Zakkysyy/poltekom-ess-enclosure/06_dokumentasi_visual/arsitektur_stack_tunnel_dan_case.png

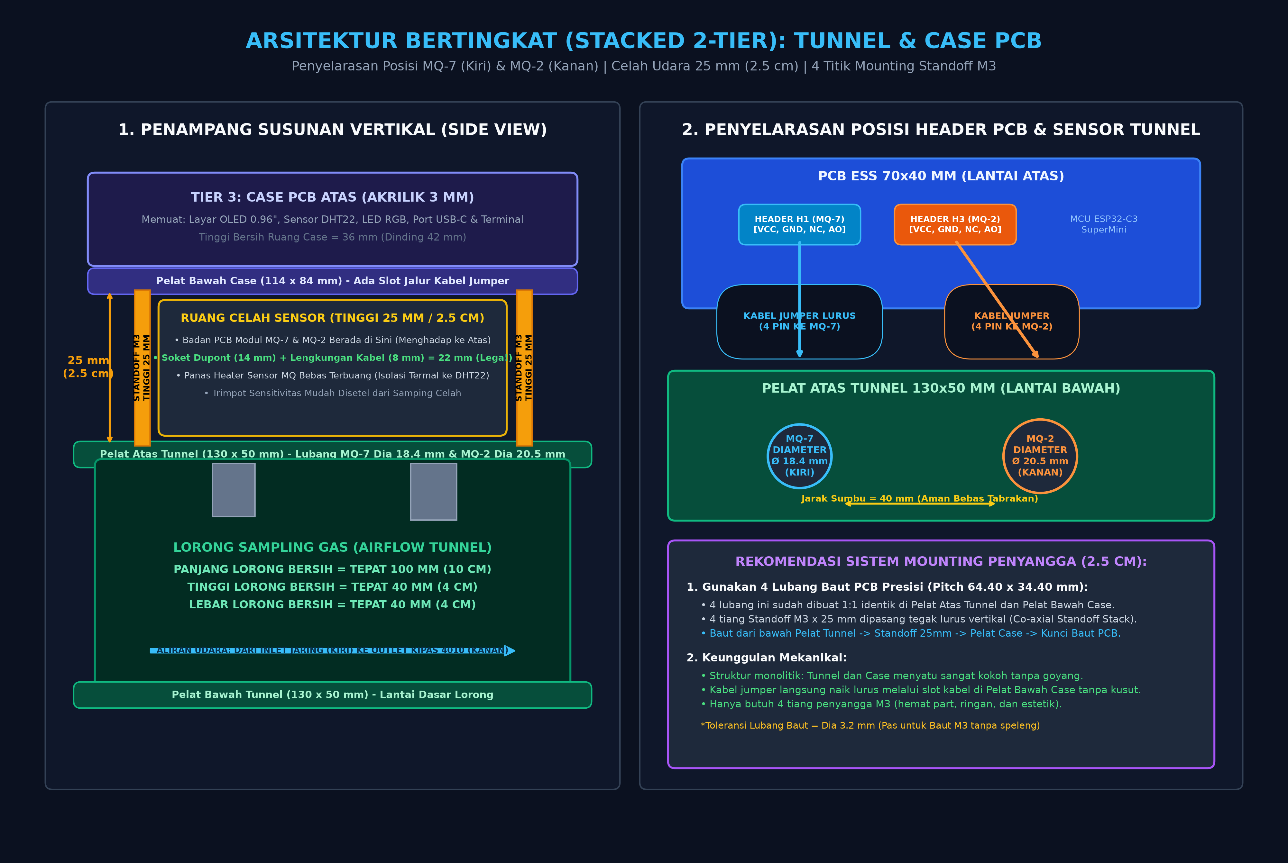
06_dokumentasi_visual/arsitektur_stack_tunnel_dan_case.png
