Zakkysyy/poltekom-ess-enclosure/06_dokumentasi_visual/desain_2d_3d_modul_mq2_mq7_pcb.png

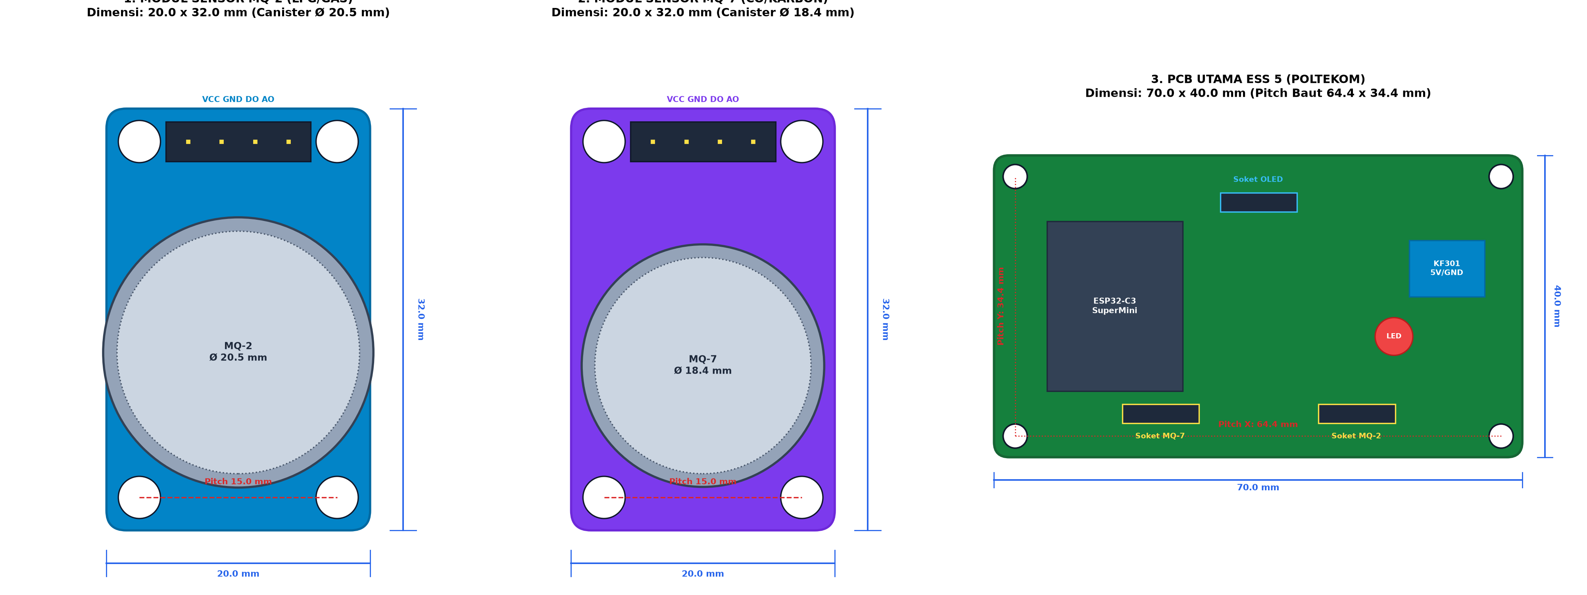
06_dokumentasi_visual/desain_2d_3d_modul_mq2_mq7_pcb.png
