Zakkysyy/poltekom-ess-enclosure/06_dokumentasi_visual/desain_3d_spacer_male_female_m3_50mm.png

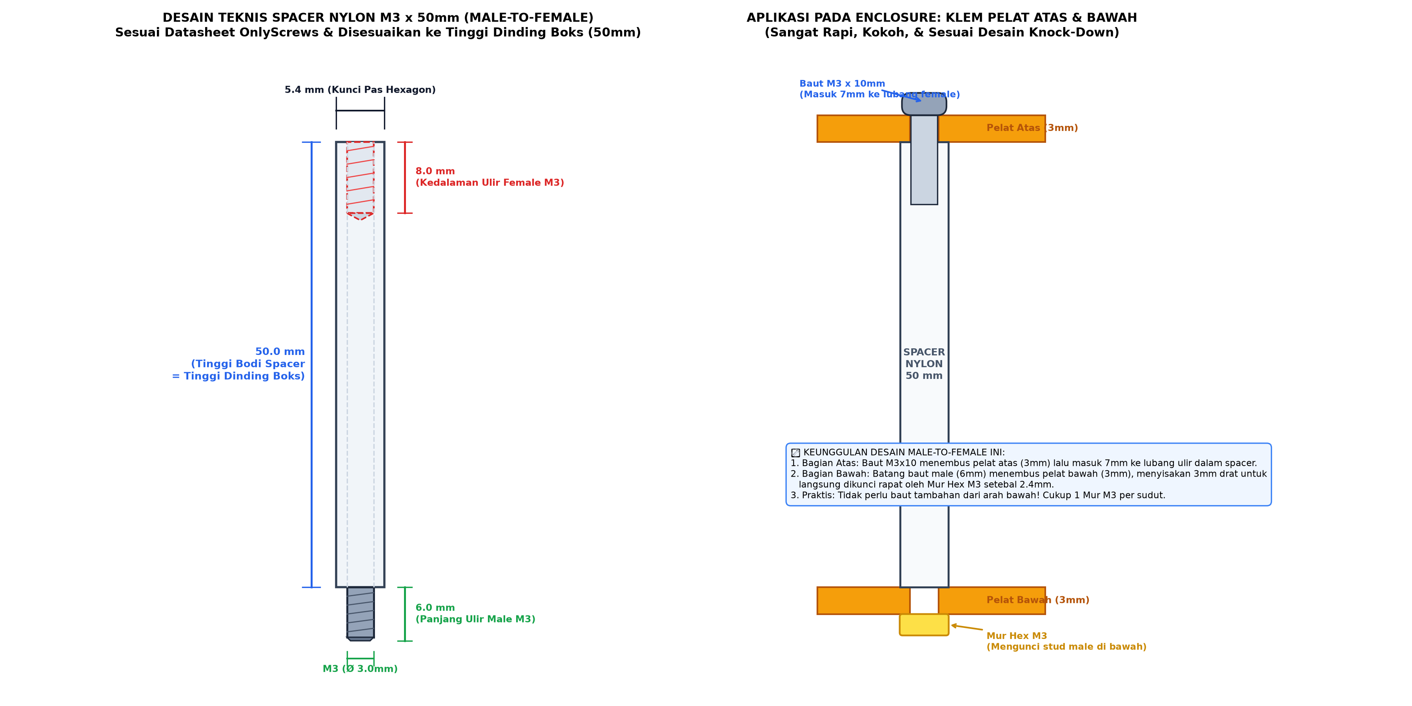
06_dokumentasi_visual/desain_3d_spacer_male_female_m3_50mm.png
