Zakkysyy/poltekom-ess-enclosure/06_dokumentasi_visual/panduan_baut_5mm_datasheet_onshape.png

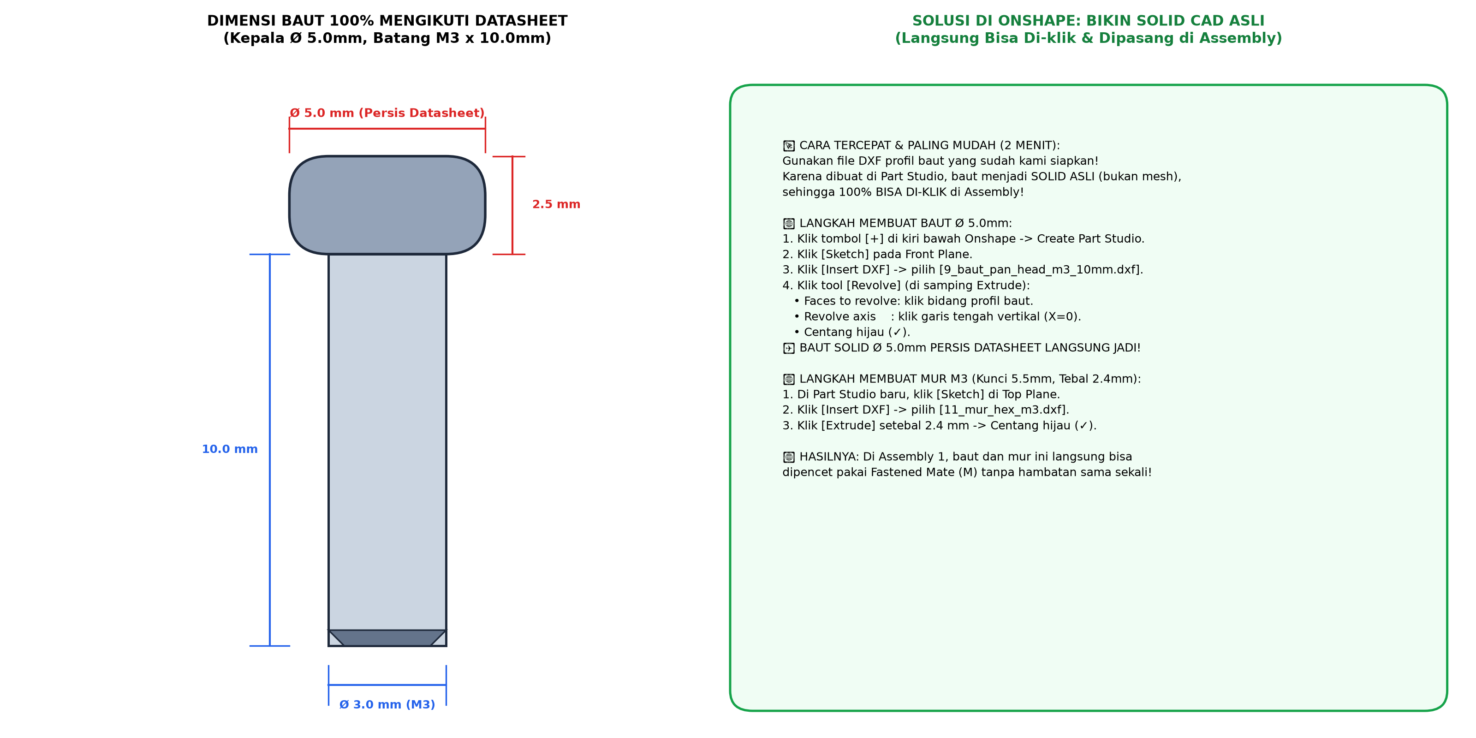
06_dokumentasi_visual/panduan_baut_5mm_datasheet_onshape.png
