Zakkysyy/poltekom-ess-enclosure/06_dokumentasi_visual/panduan_bikin_ulir_onshape.png

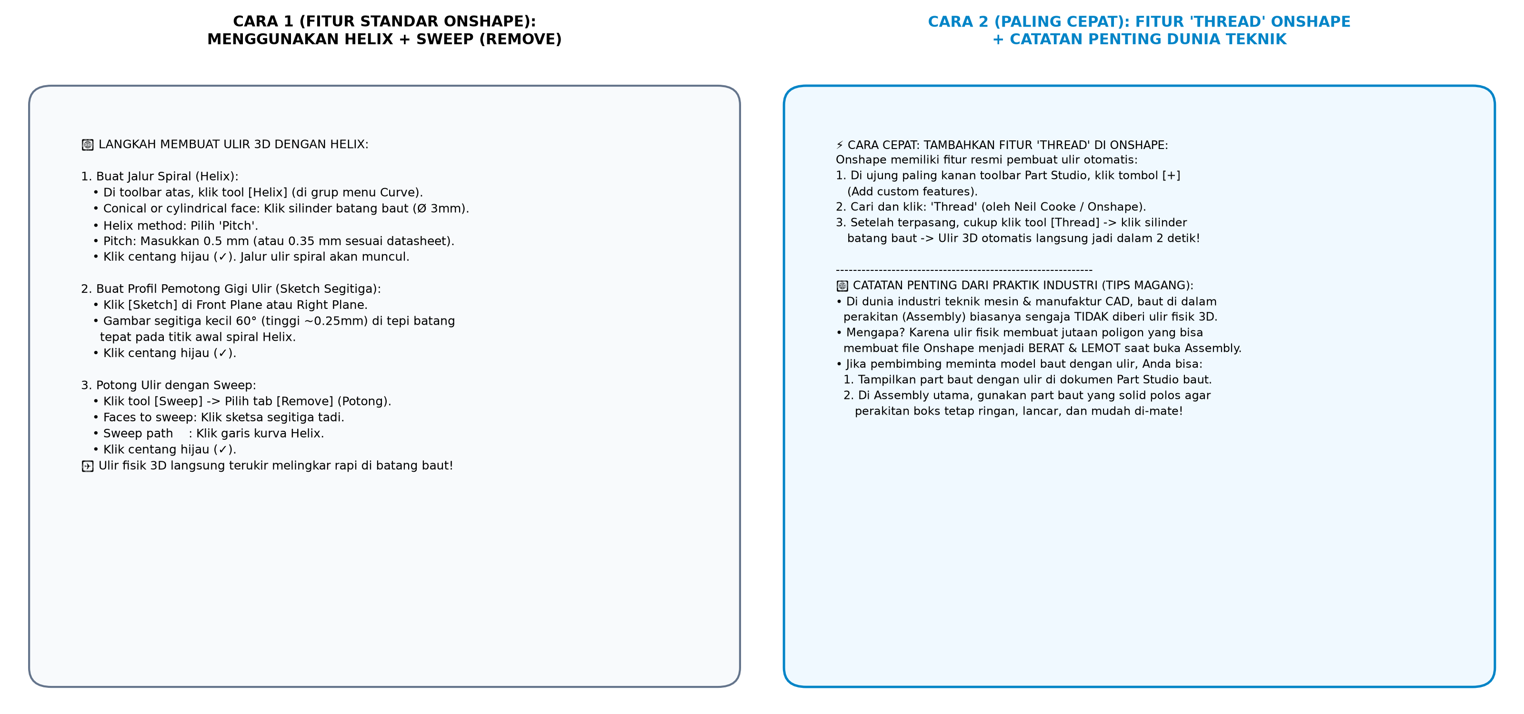
06_dokumentasi_visual/panduan_bikin_ulir_onshape.png
