Zakkysyy/poltekom-ess-enclosure/06_dokumentasi_visual/panduan_mate_baut_dan_mur_onshape.png

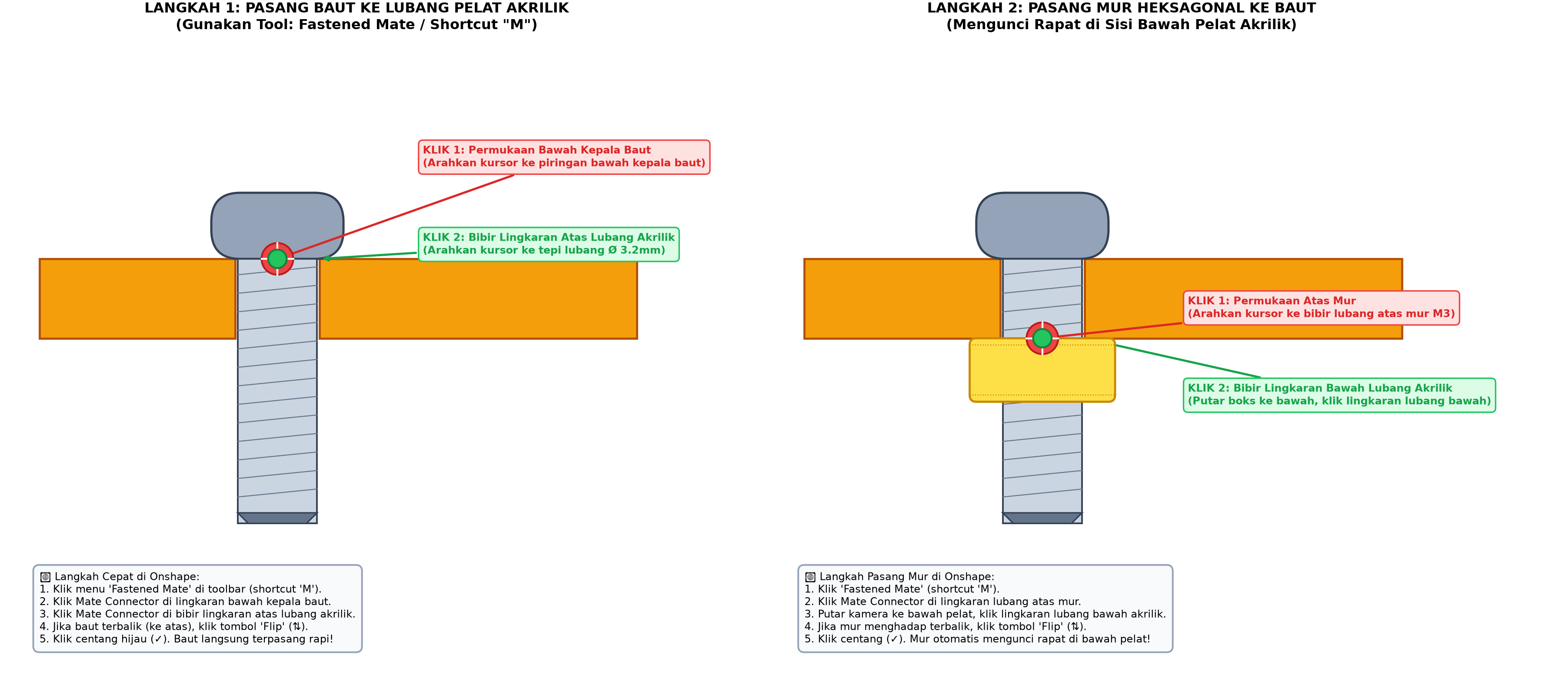
06_dokumentasi_visual/panduan_mate_baut_dan_mur_onshape.png
