Zakkysyy/poltekom-ess-enclosure/06_dokumentasi_visual/preview_a4_halaman_1.png

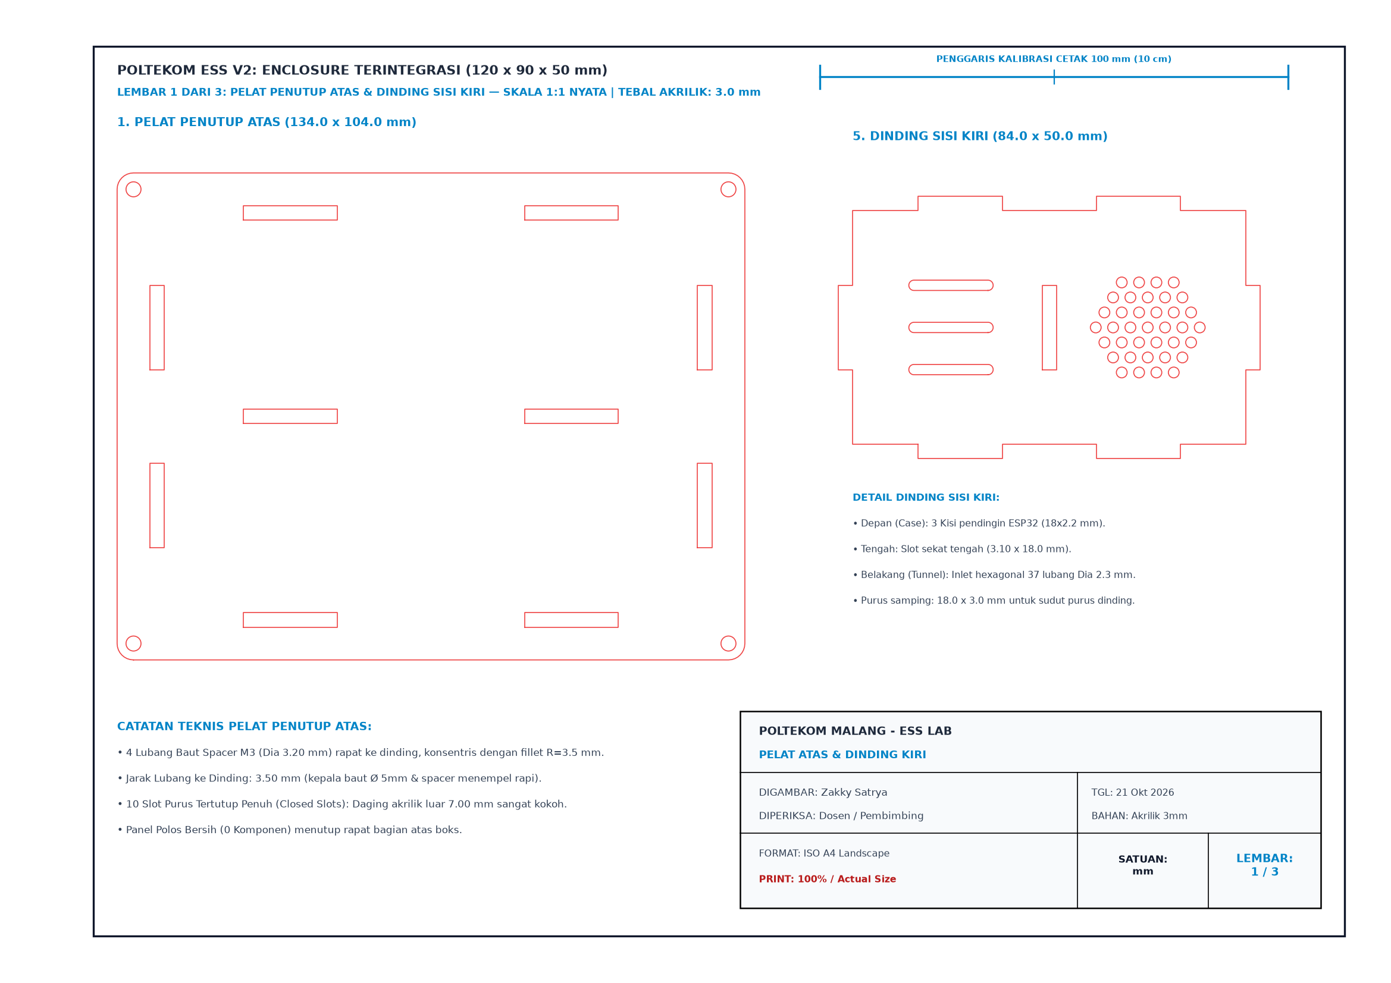
06_dokumentasi_visual/preview_a4_halaman_1.png
