Zakkysyy/poltekom-ess-enclosure/06_dokumentasi_visual/preview_a4_halaman_3.png

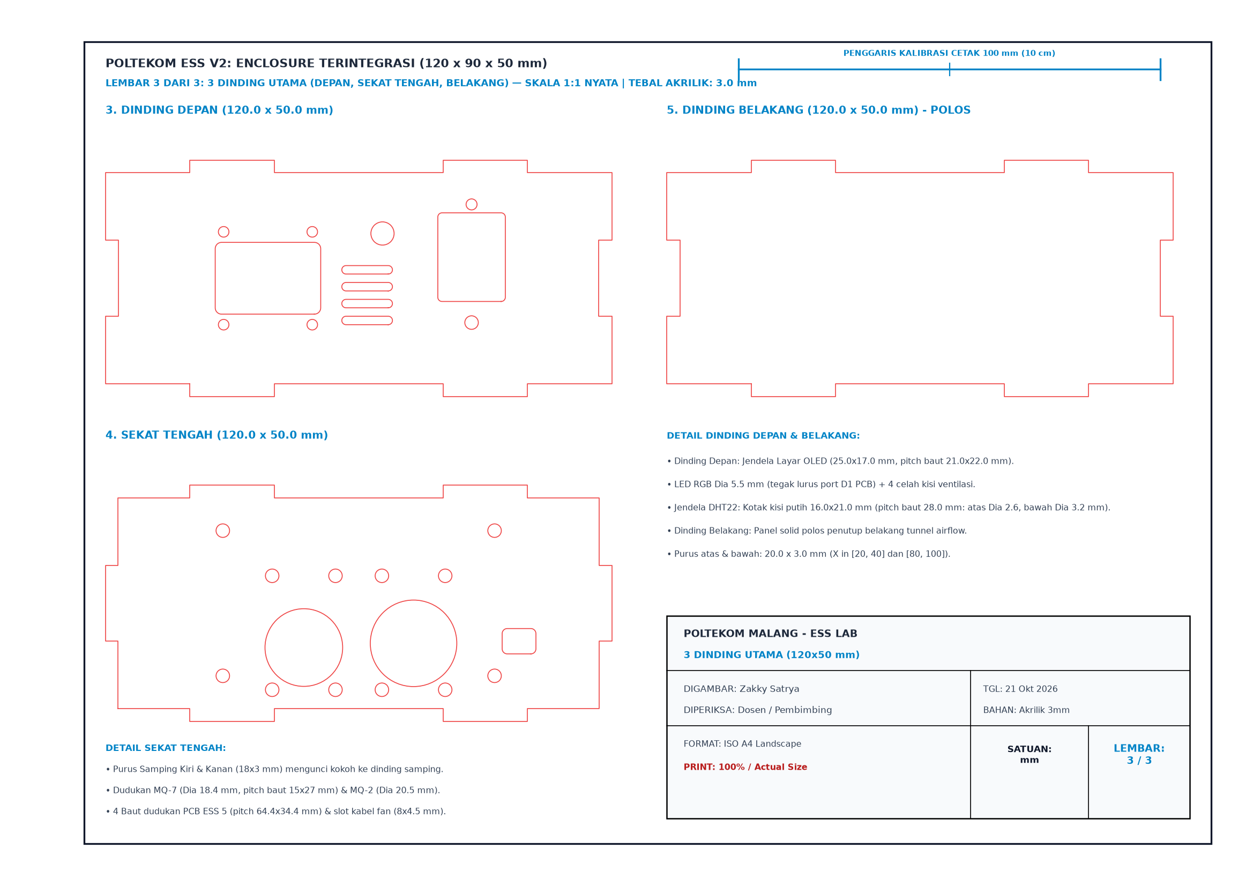
06_dokumentasi_visual/preview_a4_halaman_3.png
