Zakkysyy/poltekom-ess-enclosure/06_dokumentasi_visual/preview_dinding_kanan_grille.png

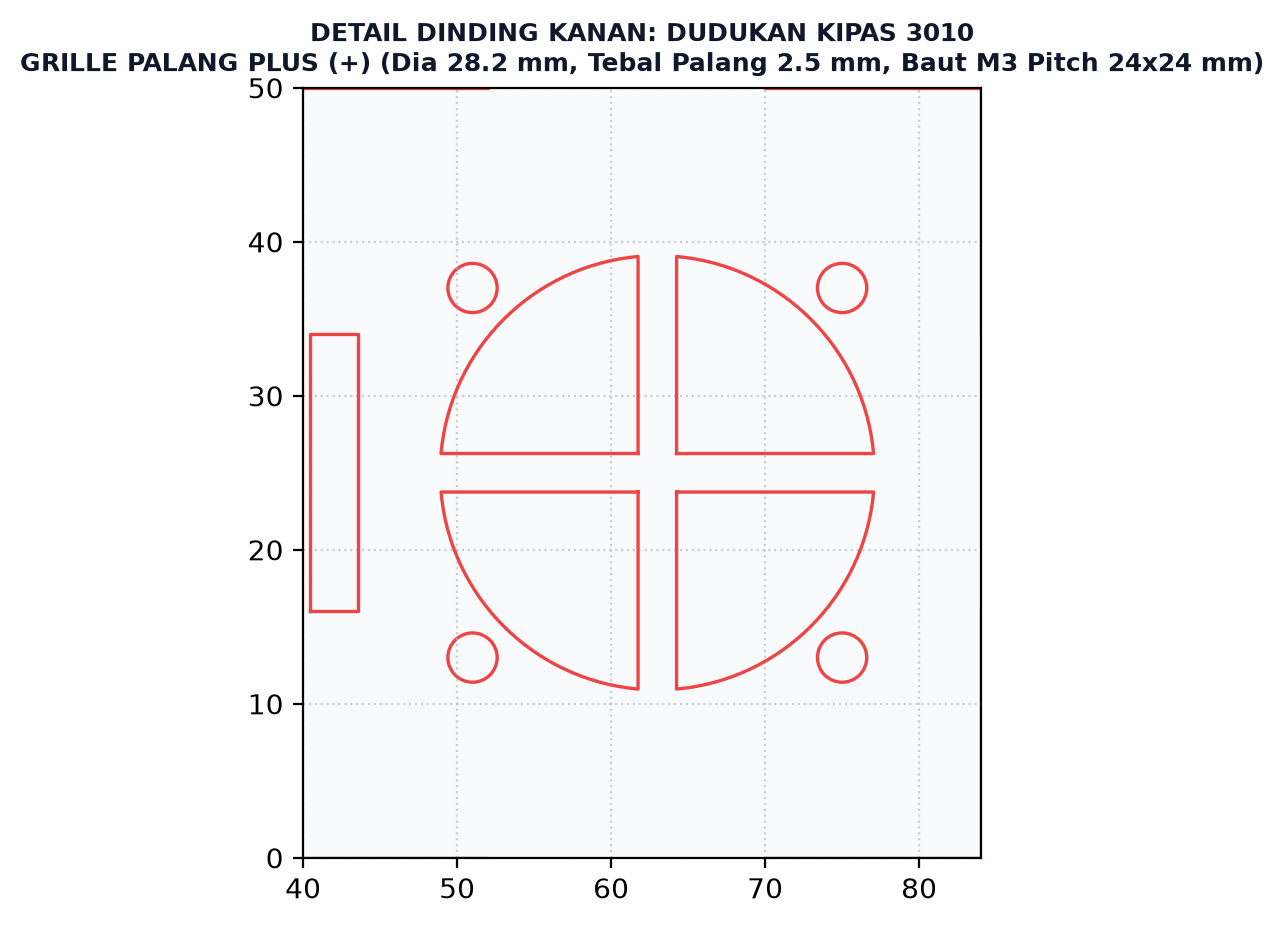
06_dokumentasi_visual/preview_dinding_kanan_grille.png
