Zakkysyy/poltekom-ess-enclosure/06_dokumentasi_visual/preview_laser_cutting_v2.png

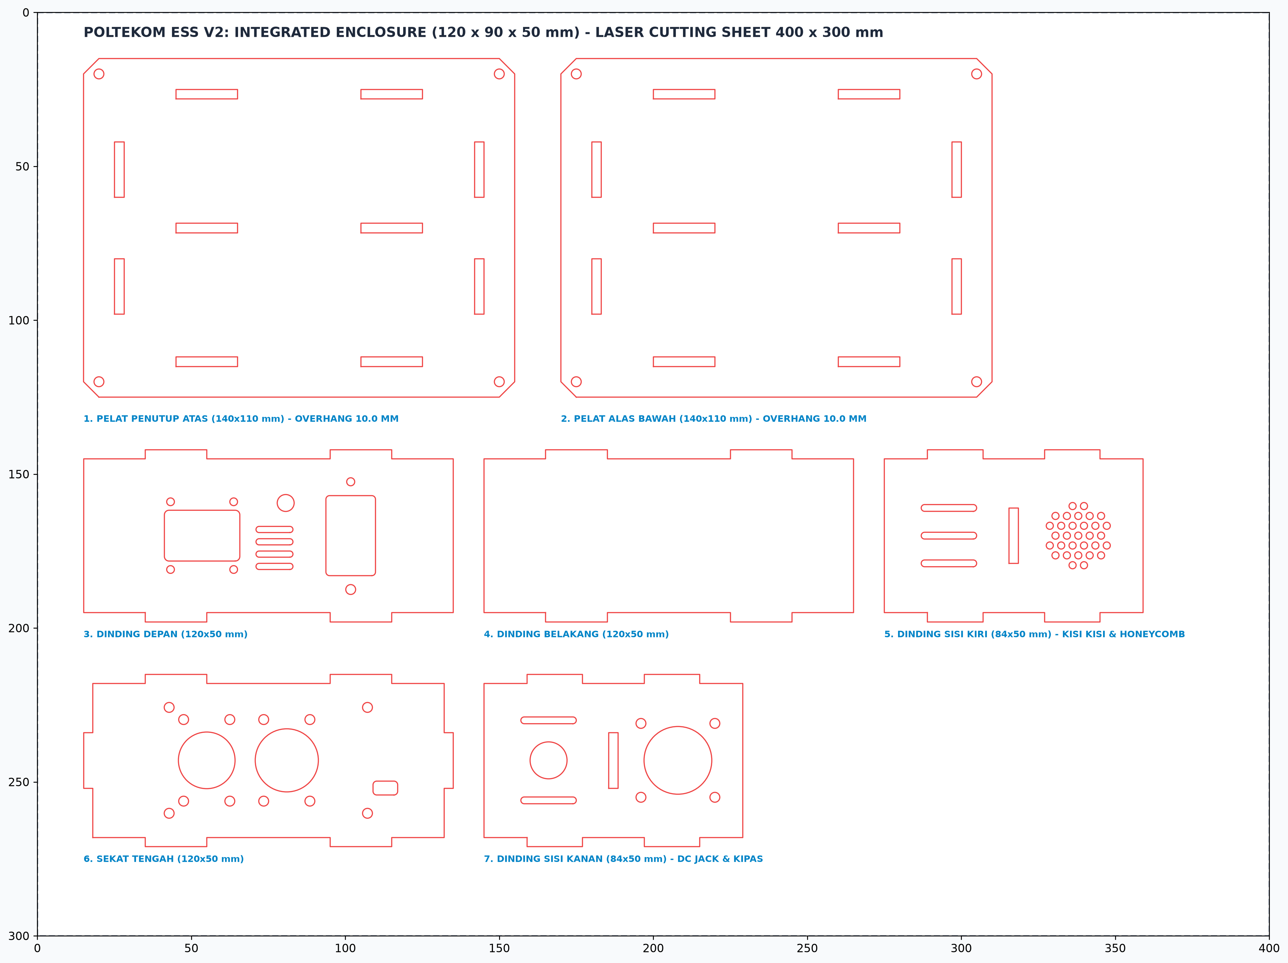
06_dokumentasi_visual/preview_laser_cutting_v2.png
