Zakkysyy/poltekom-ess-enclosure/01_dxf_akrilik_laser/07_dinding_sisi_kanan.dxf

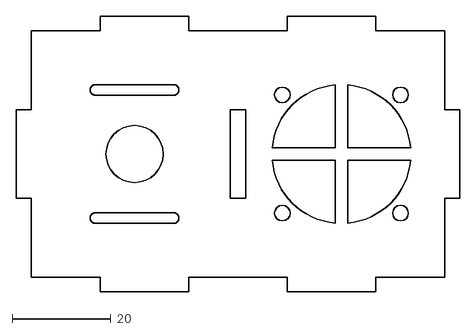
[picture p21: CAD file, 2026-10-30]
01_dxf_akrilik_laser/07_dinding_sisi_kanan.dxf
90.0 x 56.0
