Zakkysyy/poltekom-ess-enclosure/02_model_3d_stl/10_mur_hex_m3.stl

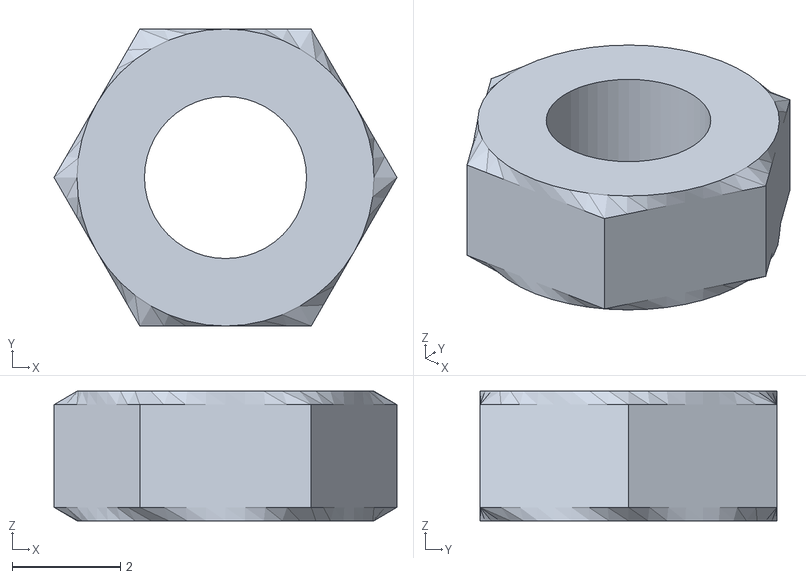
[picture p22: CAD file, 2026-10-30]
02_model_3d_stl/10_mur_hex_m3.stl
6.35 x 5.50 x 2.40
