Zakkysyy/poltekom-ess-enclosure/03_siap_potong_laser_cutting/laser_cutting_v2_integrated_box.dxf

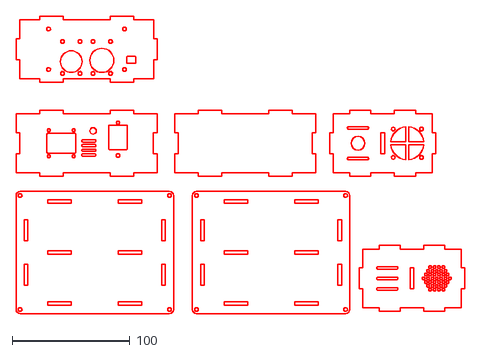
[picture p23: CAD file, 2026-10-30]
03_siap_potong_laser_cutting/laser_cutting_v2_integrated_box.dxf
382.0 x 253.0
