Zakkysyy/poltekom-ess-enclosure/01_dxf_akrilik_laser/06_dinding_sisi_kiri.dxf

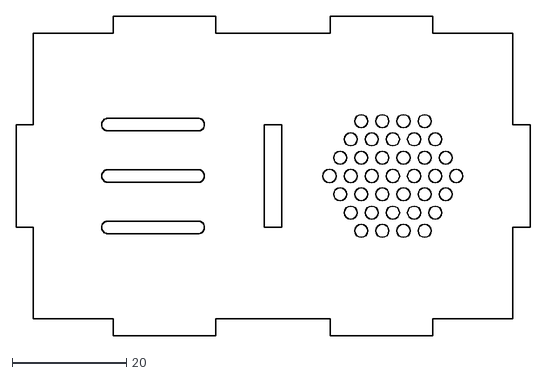
[picture p24: CAD file, 2026-10-30]
01_dxf_akrilik_laser/06_dinding_sisi_kiri.dxf
90.0 x 56.0
