Zakkysyy/poltekom-ess-enclosure/02_model_3d_stl/13_pcb_ess_5.stl

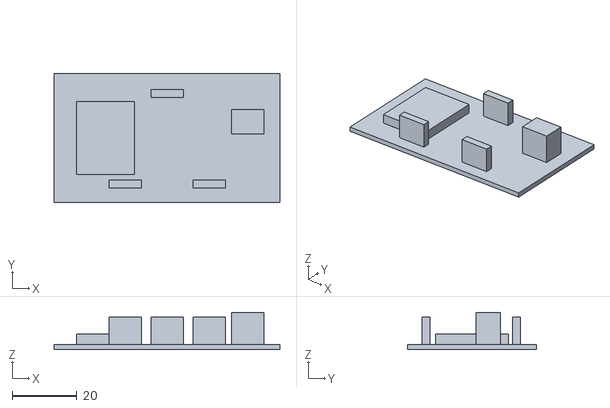
[picture p25: CAD file, 2026-10-30]
02_model_3d_stl/13_pcb_ess_5.stl
70.0 x 40.0 x 11.6
