Zakkysyy/poltekom-ess-enclosure/01_dxf_akrilik_laser/04_sekat_tengah.dxf

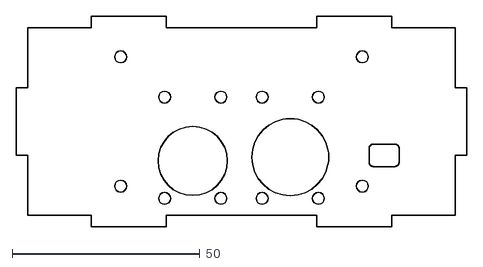
[picture p26: CAD file, 2026-10-30]
01_dxf_akrilik_laser/04_sekat_tengah.dxf
120.0 x 56.0
