Zakkysyy/poltekom-ess-enclosure/02_model_3d_stl/08_spacer_nylon_m3_50mm.stl

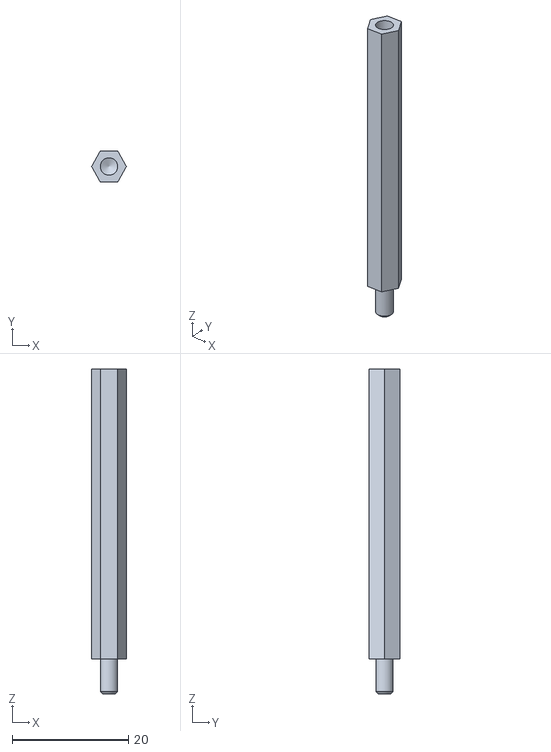
[picture p27: CAD file, 2026-10-30]
02_model_3d_stl/08_spacer_nylon_m3_50mm.stl
6.00 x 5.40 x 56.0
