Zakkysyy/poltekom-ess-enclosure/01_dxf_akrilik_laser/05_dinding_belakang.dxf

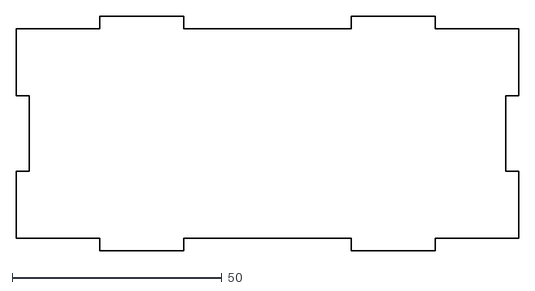
[picture p28: CAD file, 2026-10-30]
01_dxf_akrilik_laser/05_dinding_belakang.dxf
120.0 x 56.0
