Zakkysyy/poltekom-ess-enclosure/02_model_3d_stl/09_baut_pan_head_m3_10mm.stl

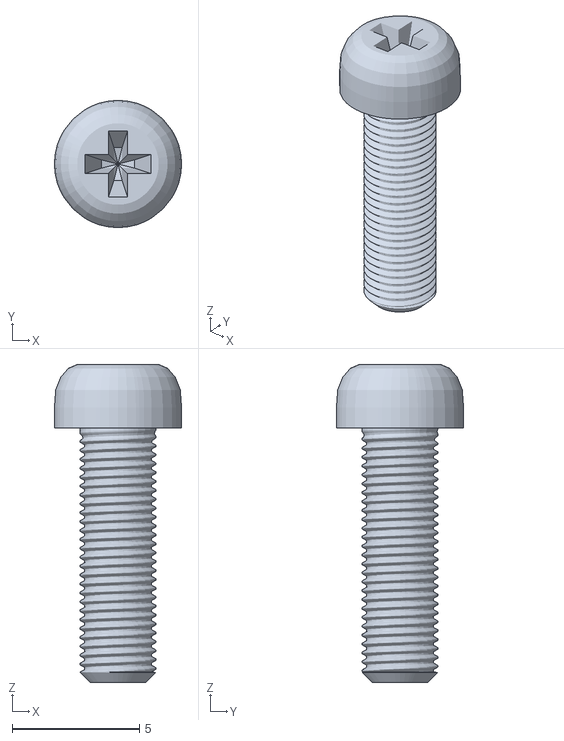
[picture p29: CAD file, 2026-10-30]
02_model_3d_stl/09_baut_pan_head_m3_10mm.stl
5.00 x 5.00 x 12.5
