Zakkysyy/poltekom-ess-enclosure/01_dxf_akrilik_laser/01_pelat_penutup_atas.dxf

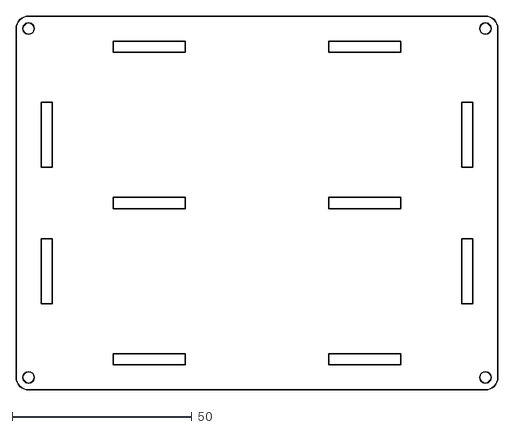
[picture p30: CAD file, 2026-10-30]
01_dxf_akrilik_laser/01_pelat_penutup_atas.dxf
134.0 x 104.0
