Zakkysyy/poltekom-ess-enclosure/02_model_3d_stl/12_modul_sensor_mq7.stl

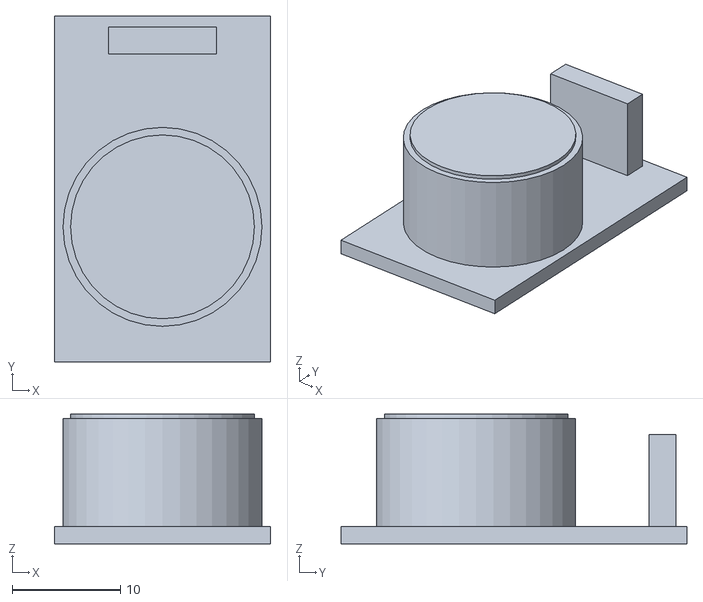
[picture p31: CAD file, 2026-10-30]
02_model_3d_stl/12_modul_sensor_mq7.stl
20.0 x 32.0 x 12.0
