Zakkysyy/poltekom-ess-enclosure/01_dxf_akrilik_laser/02_pelat_dasar_bawah.dxf

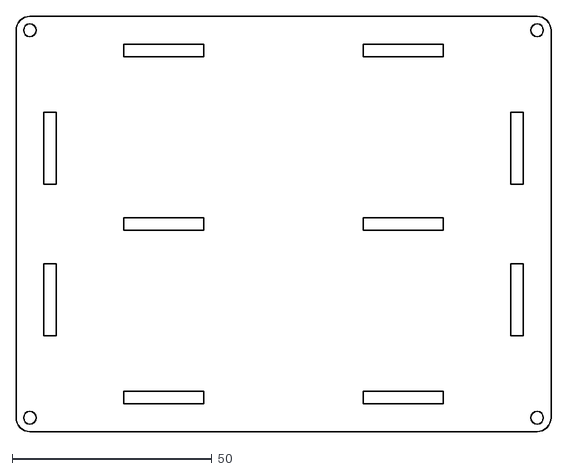
[picture p32: CAD file, 2026-10-30]
01_dxf_akrilik_laser/02_pelat_dasar_bawah.dxf
134.0 x 104.0
