Zakkysyy/poltekom-ess-enclosure/02_model_3d_stl/11_modul_sensor_mq2.stl

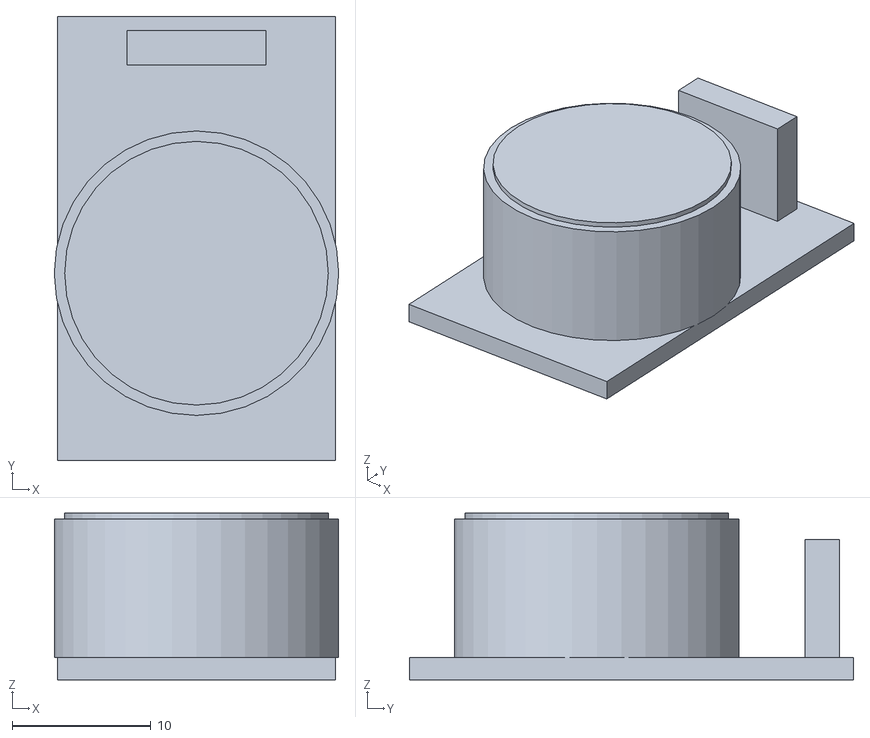
[picture p33: CAD file, 2026-10-30]
02_model_3d_stl/11_modul_sensor_mq2.stl
20.5 x 32.0 x 12.0
