Zakkysyy/poltekom-ess-enclosure/01_dxf_akrilik_laser/03_dinding_depan.dxf

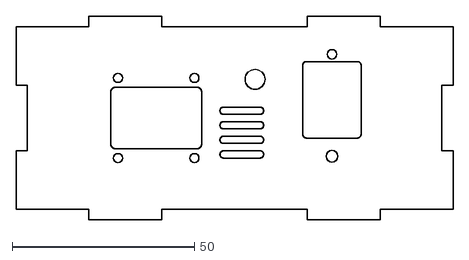
[picture p34: CAD file, 2026-10-30]
01_dxf_akrilik_laser/03_dinding_depan.dxf
120.0 x 56.0
