Zakkysyy/poltekom-ess-enclosure/03_siap_potong_laser_cutting/laser_cutting_v2_integrated_box_1to1.pdf

POLTEKOM ESS V2: INTEGRATED ENCLOSURE (120 x 90 x 50 mm) - SKALA 1:1 LASER CUTTING SHEET 400 x 300 mm

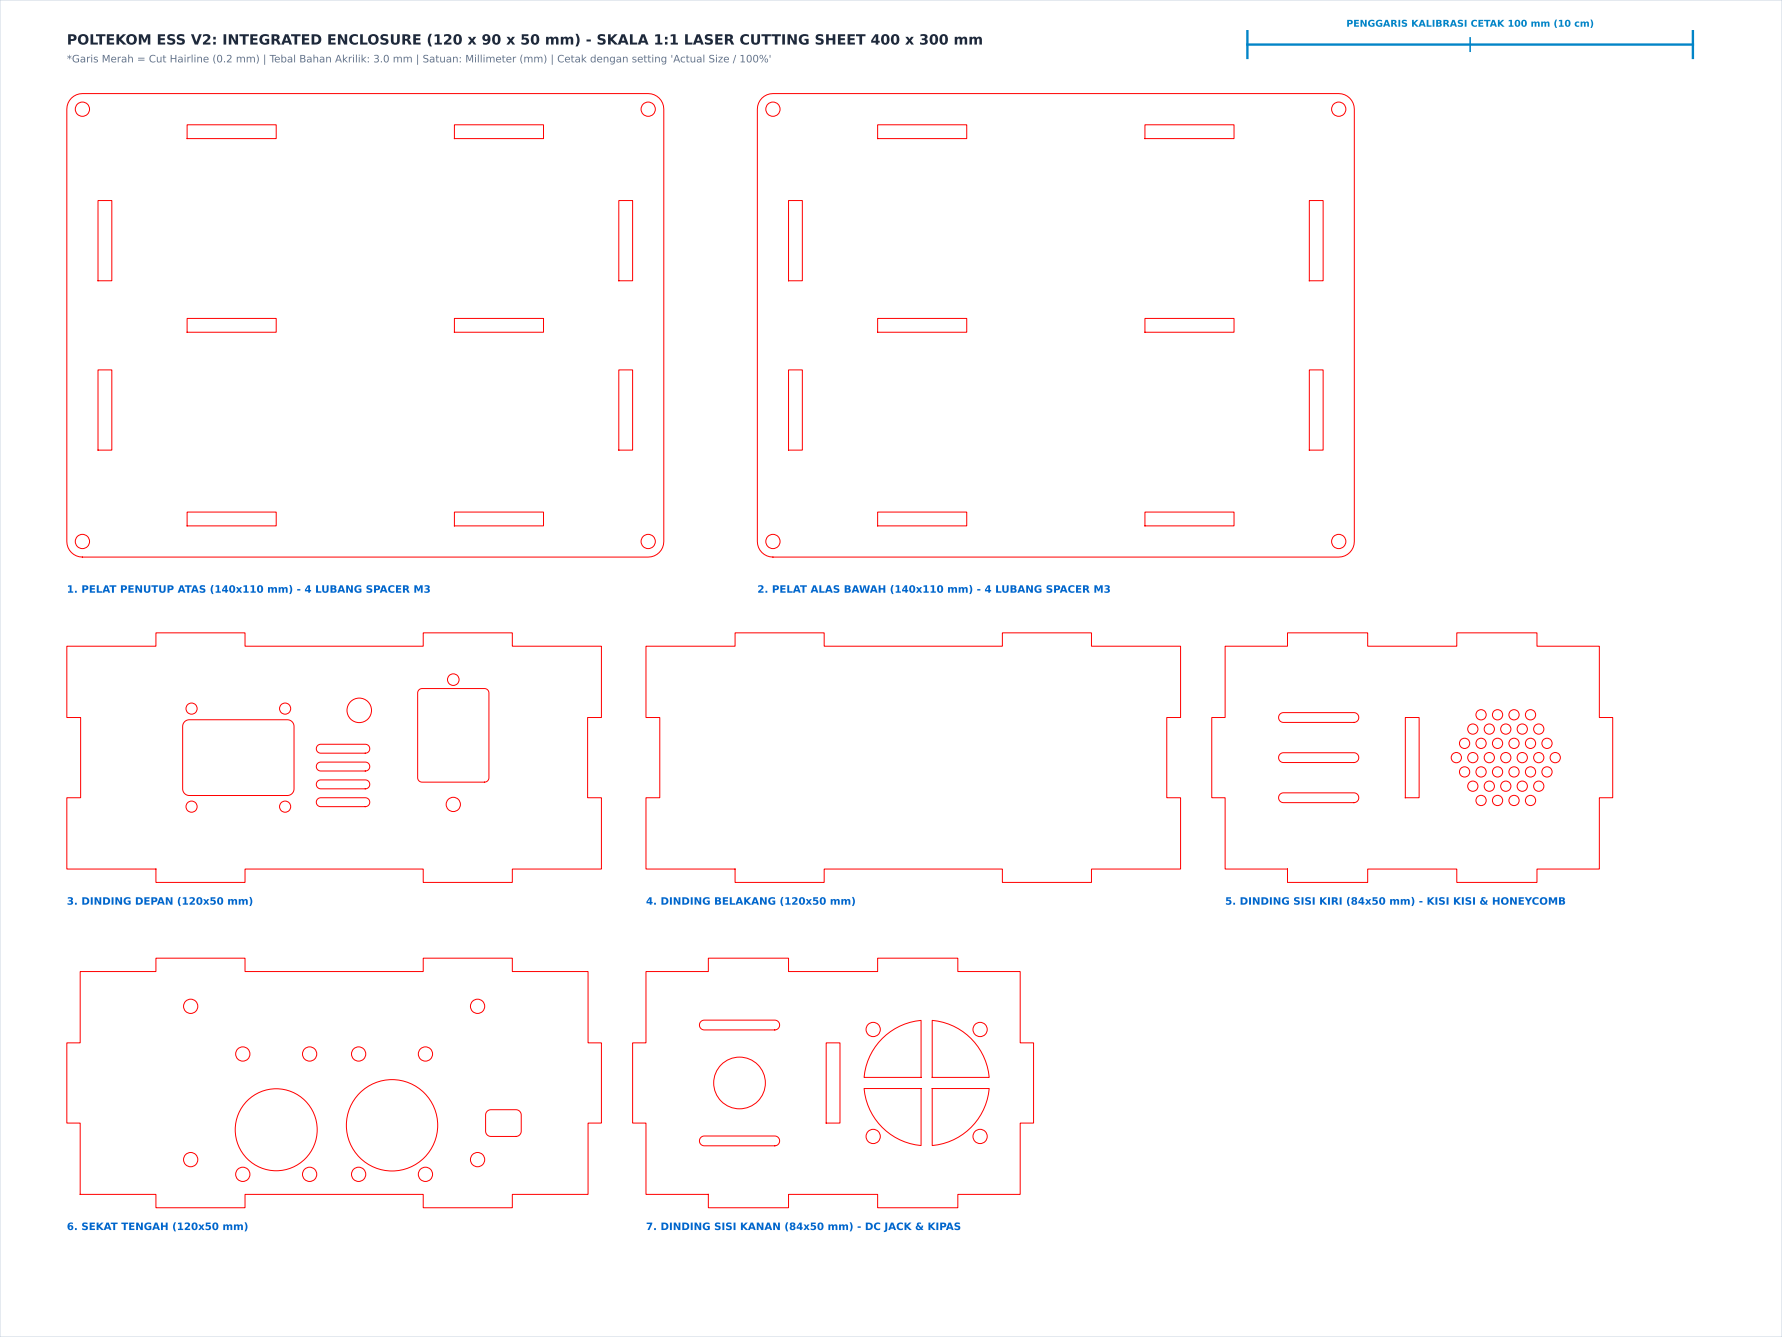
[picture p35: page 1]
1. PELAT PENUTUP ATAS (140x110 mm) - 4 LUBANG SPACER M3; 2. PELAT ALAS BAWAH (140x110 mm) - 4 LUBANG SPACER M3; 3. DINDING DEPAN (120x50 mm); 4. DINDING BELAKANG (120x50 mm); 5. DINDING SISI KIRI (84x50 mm) - KISI KISI & HONEYCOMB; 6. SEKAT TENGAH (120x50 mm); 7. DINDING SISI KANAN (84x50 mm) - DC JACK & KIPAS

PENGGARIS KALIBRASI CETAK 100 mm (10 cm)

*Garis Merah = Cut Hairline (0.2 mm) | Tebal Bahan Akrilik: 3.0 mm | Satuan: Millimeter (mm) | Cetak dengan setting 'Actual Size / 100%'
