Zakkysyy/poltekom-ess-enclosure/04_gambar_kerja_cetak_a4_1to1/Gambar_Kerja_Teknik_A3_Skala_1to1.pdf

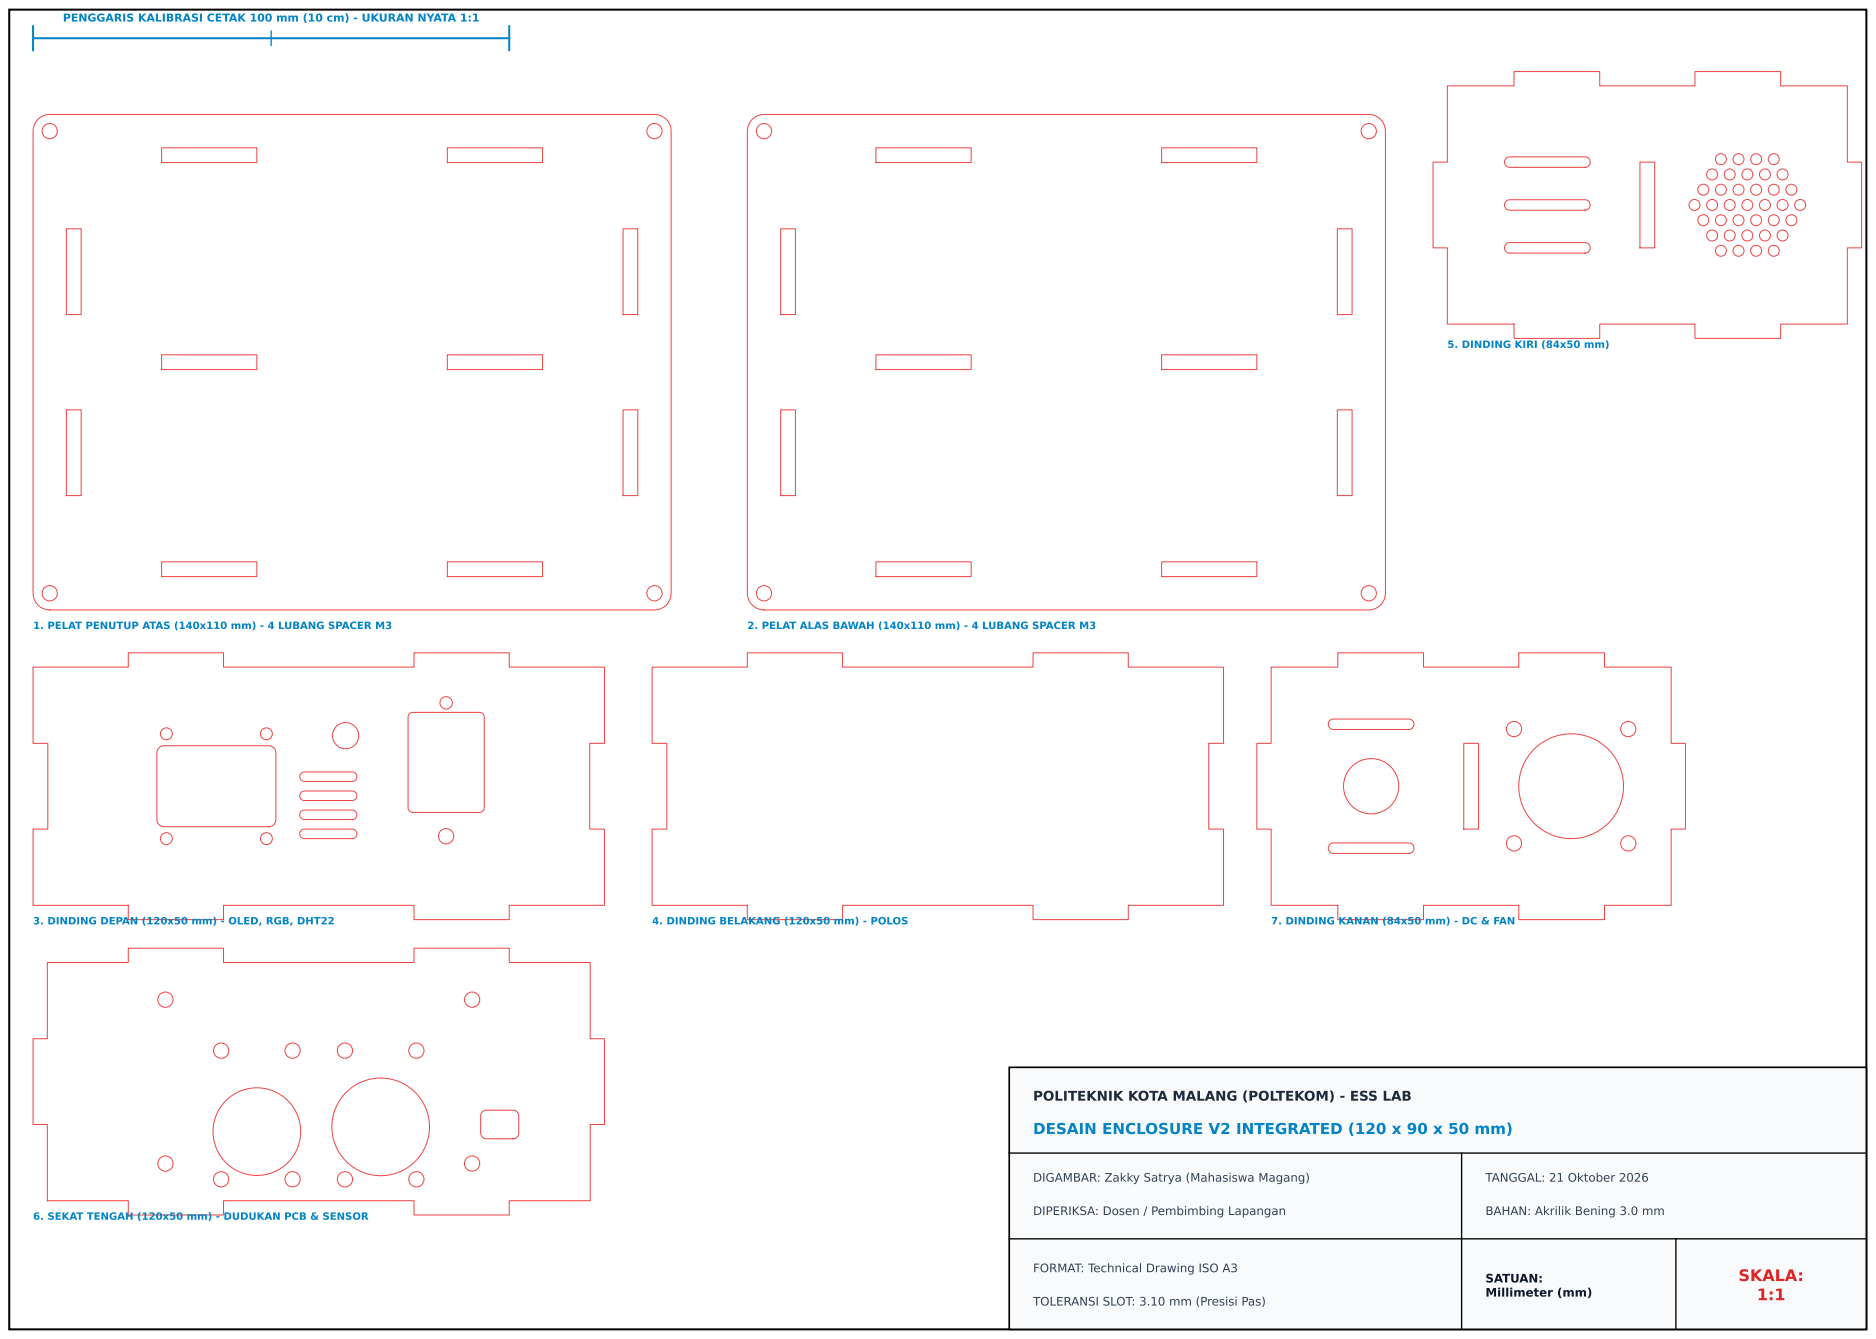
[picture p36: page 1]
TANGGAL: 21 Oktober 2026; SATUAN: Millimeter (mm); SKALA: 1:1; 1. PELAT PENUTUP ATAS (140x110 mm) - 4 LUBANG SPACER M3; 2. PELAT ALAS BAWAH (140x110 mm) - 4 LUBANG SPACER M3; 3. DINDING DEPAN (120x50 mm) - OLED, RGB, DHT22; 4. DINDING BELAKANG (120x50 mm) - POLOS; 7. DINDING KANAN (84x50 mm) - DC & FAN

PENGGARIS KALIBRASI CETAK 100 mm (10 cm) - UKURAN NYATA 1:1

5. DINDING KIRI (84x50 mm)

POLITEKNIK KOTA MALANG (POLTEKOM) - ESS LAB
DESAIN ENCLOSURE V2 INTEGRATED (120 x 90 x 50 mm)

DIGAMBAR: Zakky Satrya (Mahasiswa Magang)

6. SEKAT TENGAH (120x50 mm) - DUDUKAN PCB & SENSOR

DIPERIKSA: Dosen / Pembimbing Lapangan

BAHAN: Akrilik Bening 3.0 mm

FORMAT: Technical Drawing ISO A3

TOLERANSI SLOT: 3.10 mm (Presisi Pas)
