Zakkysyy/poltekom-ess-enclosure/(list of files, drawings)

Other design files:
05_firmware_dan_skematik/PCB_PCB_ESS_5_2026-10-09.json
